MarcoGrazi/PR-02-NightCrawler-2017/Photoes/electronicsbox.jpg

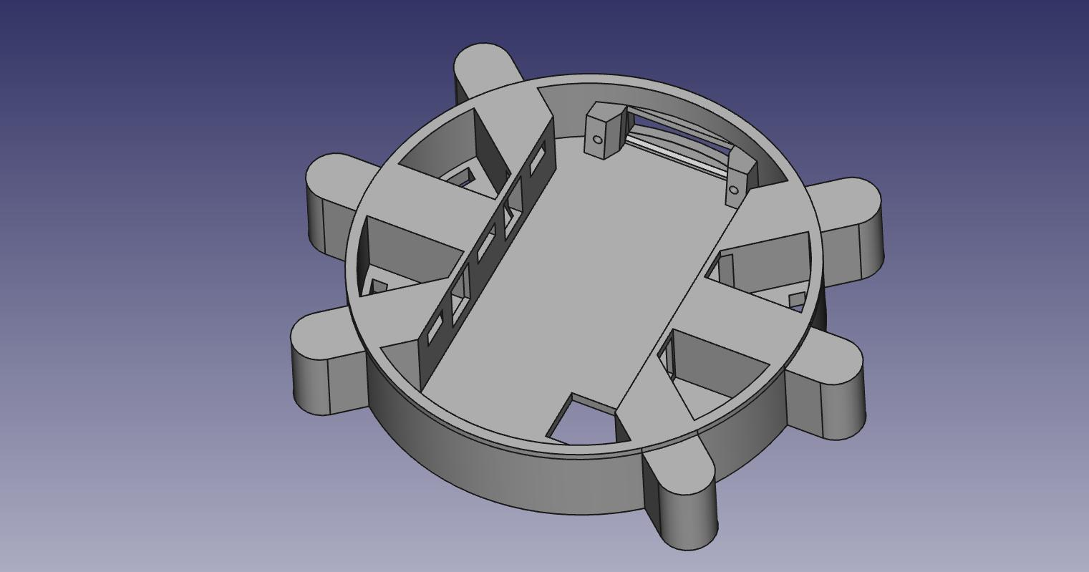
Photoes/electronicsbox.jpg
