MarcoGrazi/PR-02-NightCrawler-2017/Photoes/IMG_6573.jpg

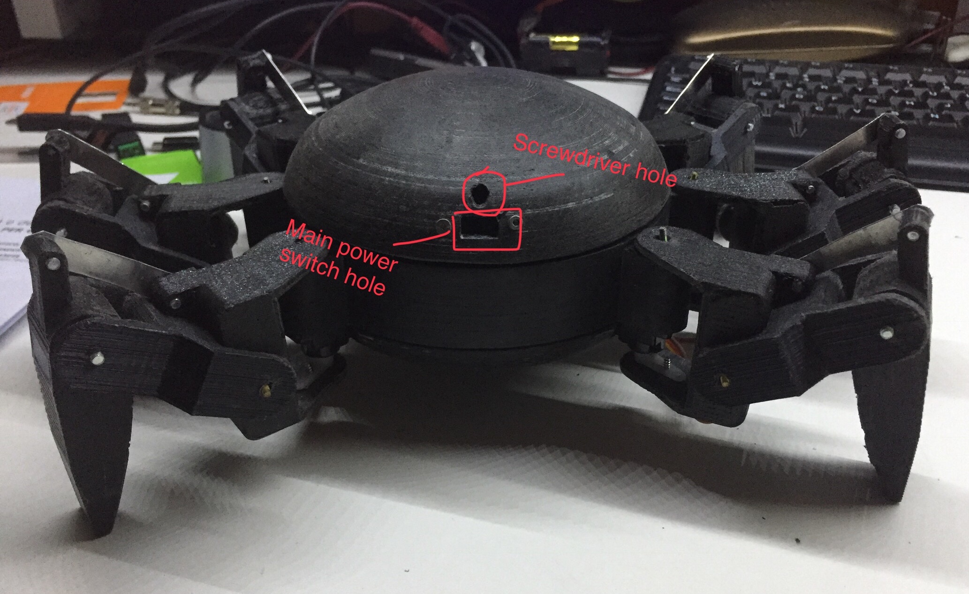
Photoes/IMG_6573.jpg
