MarcoGrazi/PR-02-NightCrawler-2017/Photoes/batterybox.png

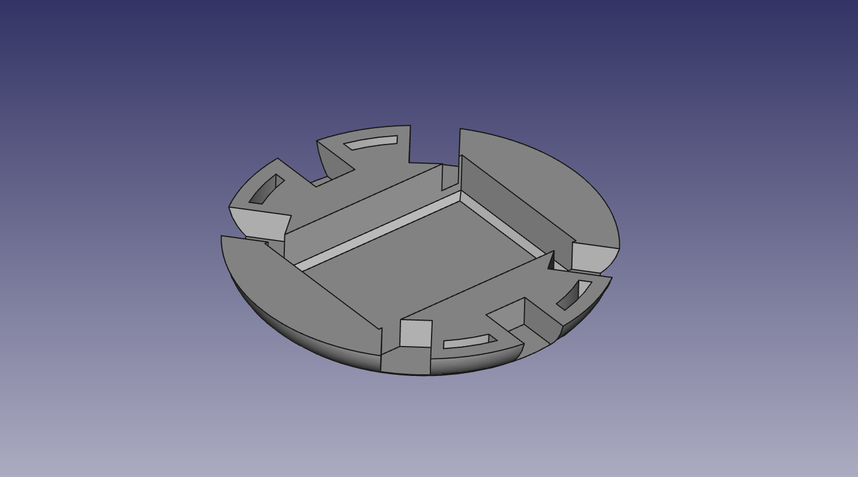
Photoes/batterybox.png
