MarcoGrazi/PR-02-NightCrawler-2017/Photoes/femurs.jpg

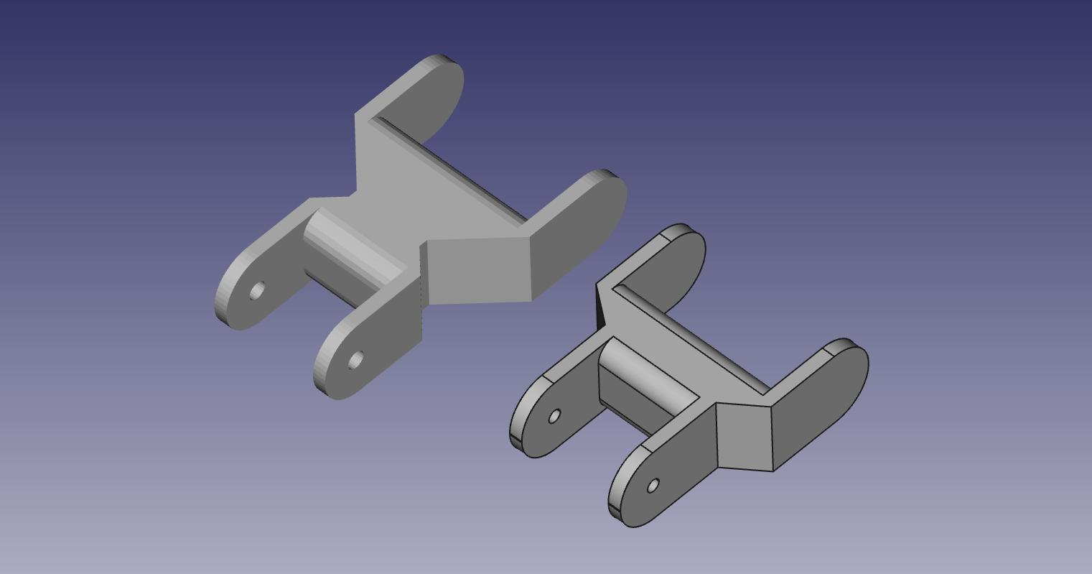
Photoes/femurs.jpg
