MarcoGrazi/PR-02-NightCrawler-2017/Photoes/head exterior.jpg

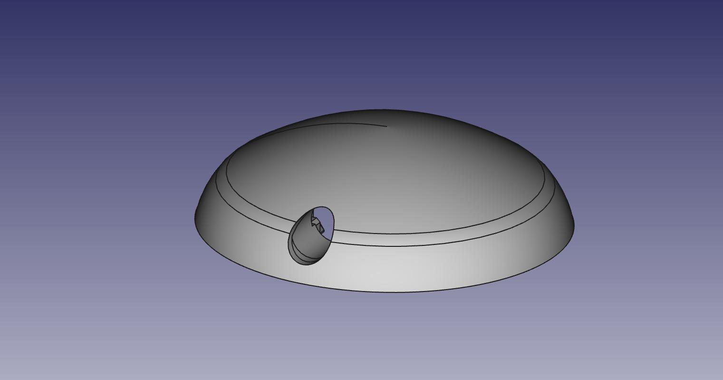
Photoes/head exterior.jpg
