MarcoGrazi/PR-02-NightCrawler-2017/Photoes/head interior.jpg

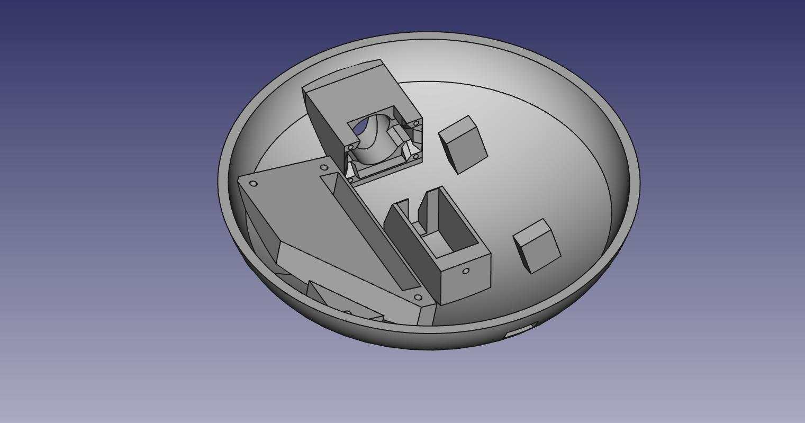
Photoes/head interior.jpg
