MarcoGrazi/PR-02-NightCrawler-2017/Photoes/IMG_6570.JPG

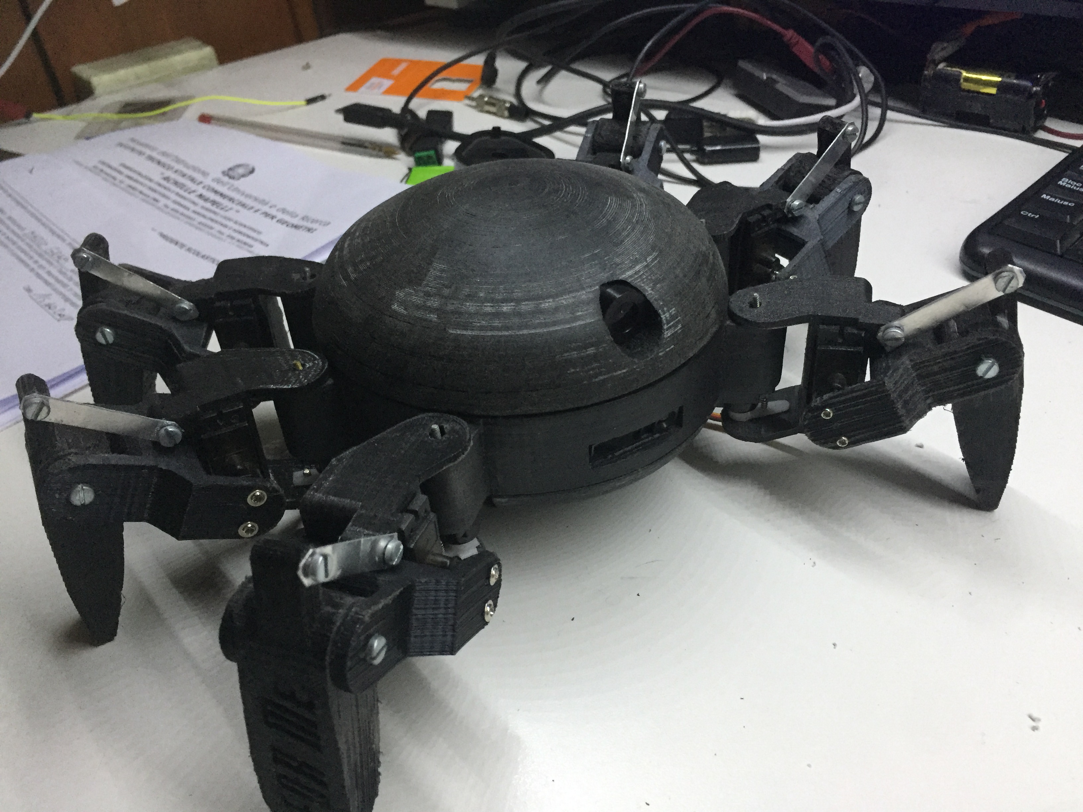
Photoes/IMG_6570.JPG
