MarcoGrazi/PR-02-NightCrawler-2017/Photoes/IMG_6571.JPG

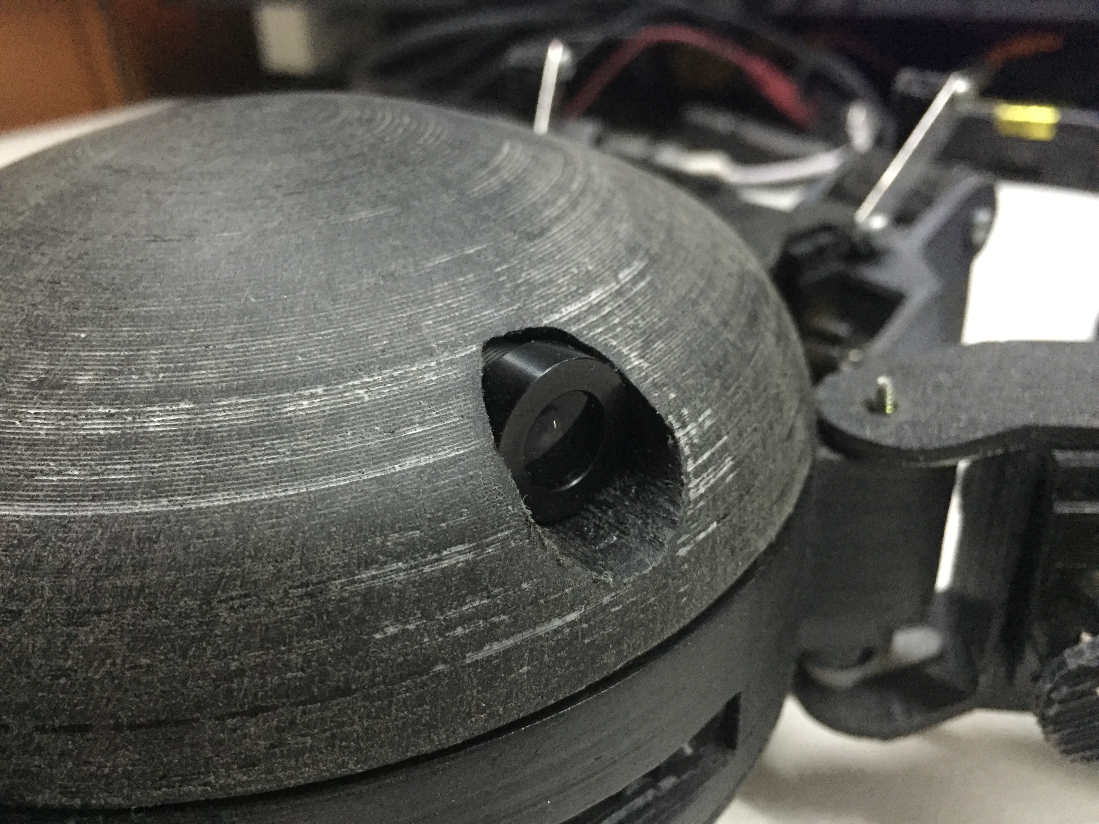
Photoes/IMG_6571.JPG
