MarcoGrazi/PR-02-NightCrawler-2017/Photoes/IMG_6574.JPG

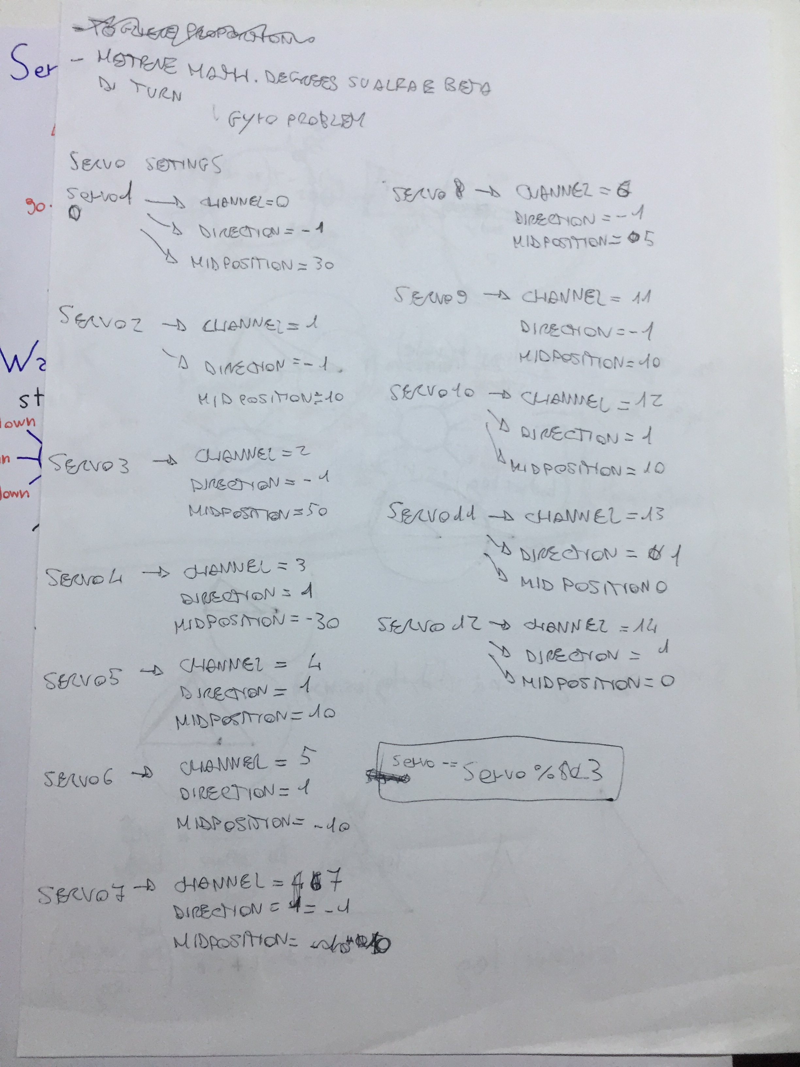
Photoes/IMG_6574.JPG
