MarcoGrazi/PR-02-NightCrawler-2017/Software/adc-05.png

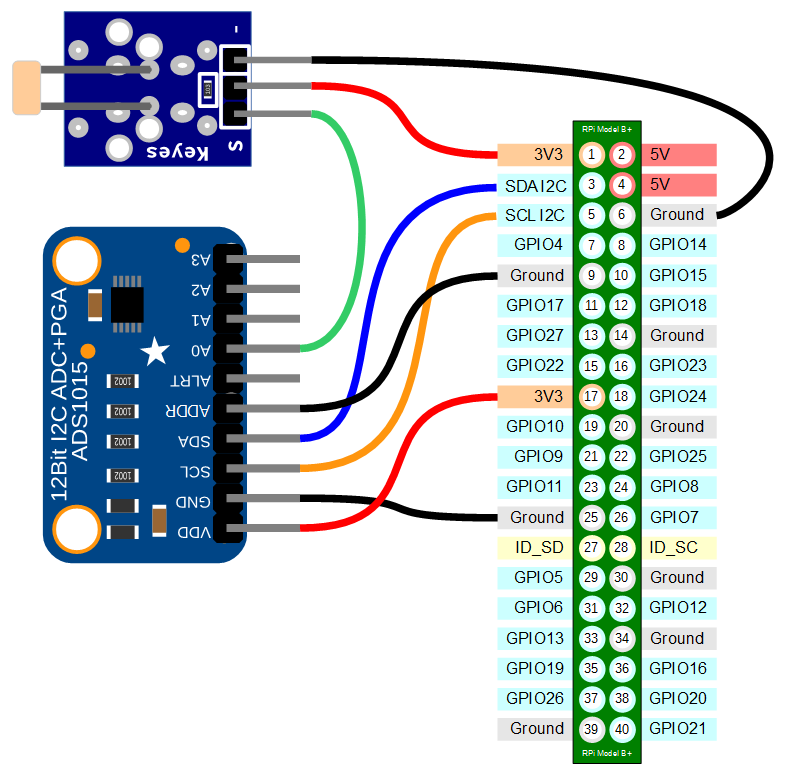
Software/adc-05.png
