MarcoGrazi/PR-02-NightCrawler-2017/CAD/main body/assembled/assembled.FCStd

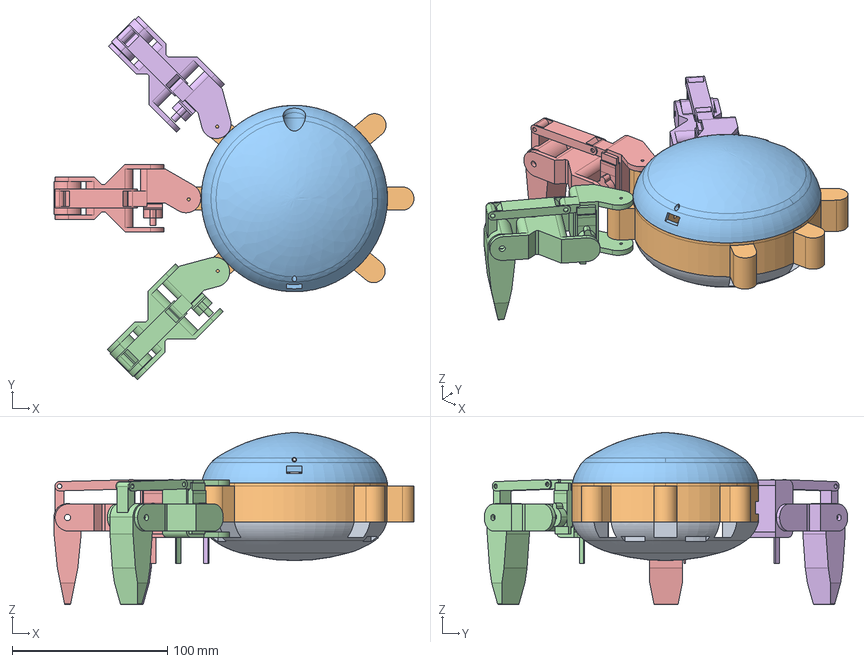
[picture p16: CAD file, 2020-03-03]
CAD/main body/assembled/assembled.FCStd
231.8 x 234.0 x 110.8 mm
