MarcoGrazi/PR-02-NightCrawler-2017/CAD/main body/assembled.FCStd

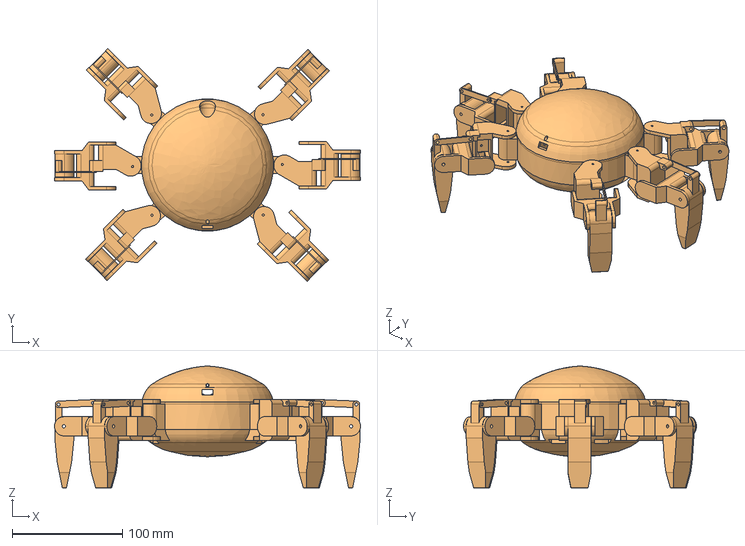
[picture p17: CAD file, 2020-03-03]
CAD/main body/assembled.FCStd
278.0 x 211.5 x 110.8 mm
