MarcoGrazi/PR-02-NightCrawler-2017/CAD/leg/femore/anca/anca.FCStd

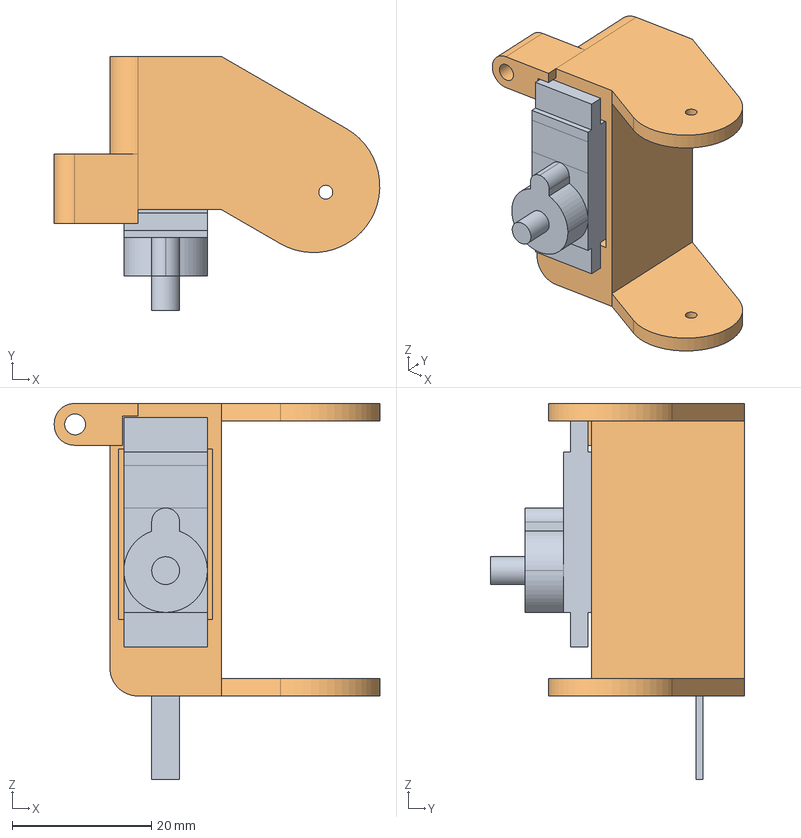
[picture p18: CAD file, 2020-03-03]
CAD/leg/femore/anca/anca.FCStd
46.8 x 36.5 x 54.0 mm
