MarcoGrazi/PR-02-NightCrawler-2017/CAD/leg/leg.FCStd

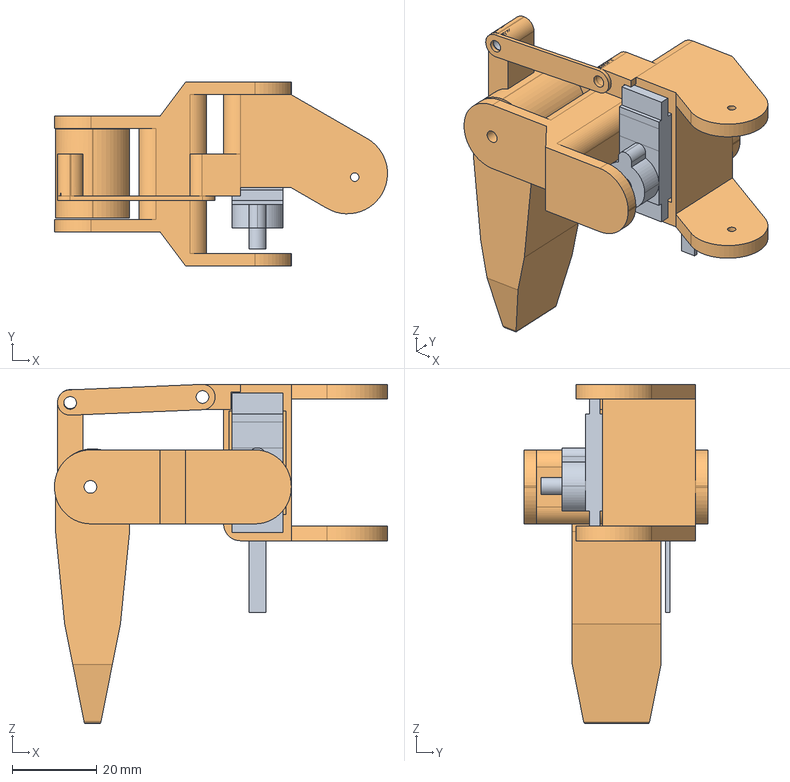
[picture p20: CAD file, 2020-03-03]
CAD/leg/leg.FCStd
78.8 x 43.5 x 80.2 mm
