MarcoGrazi/PR-02-NightCrawler-2017/CAD/leg/tendine/tendine.FCStd

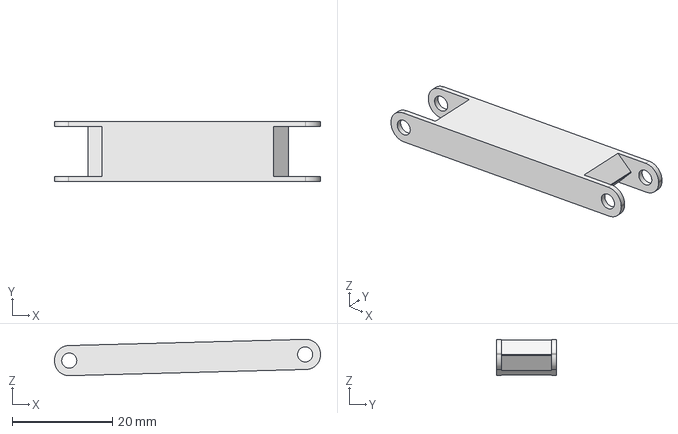
[picture p21: CAD file, 2020-03-03]
CAD/leg/tendine/tendine.FCStd
53.0 x 12.0 x 7.23 mm
