MarcoGrazi/PR-02-NightCrawler-2017/CAD/leg/tibia/For Me.stl

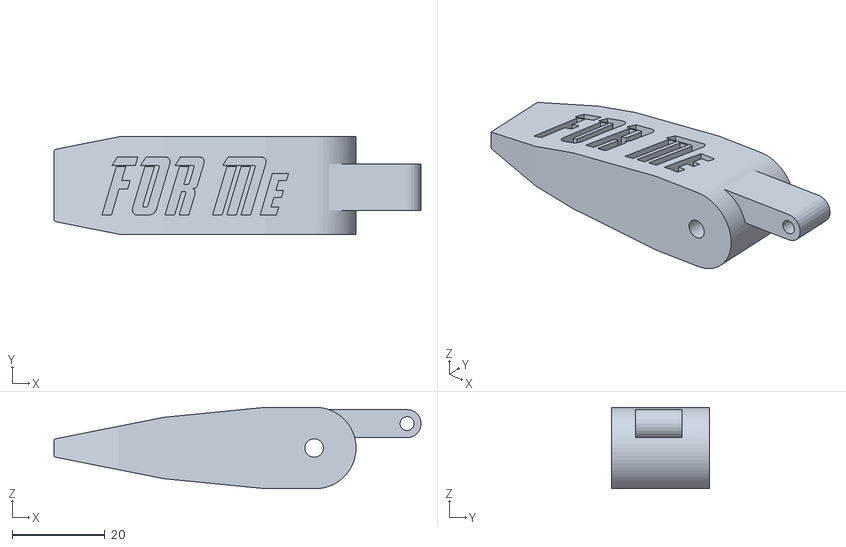
[picture p22: CAD file, 2020-03-03]
CAD/leg/tibia/For Me.stl
79.0 x 21.0 x 17.5
