MarcoGrazi/PR-02-NightCrawler-2017/CAD/main body/battery container/battery container.FCStd

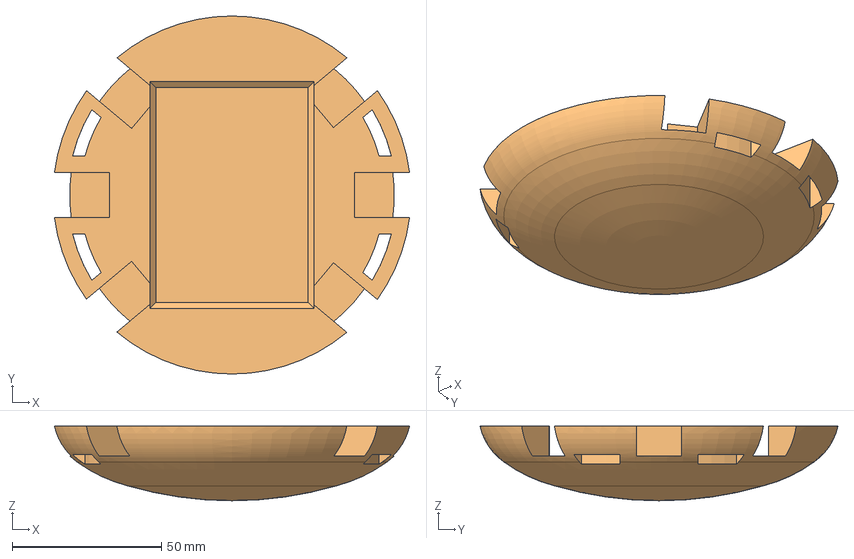
[picture p23: CAD file, 2020-03-03]
CAD/main body/battery container/battery container.FCStd
119.1 x 120.0 x 25.0 mm
