MarcoGrazi/PR-02-NightCrawler-2017/CAD/main body/battery.FCStd

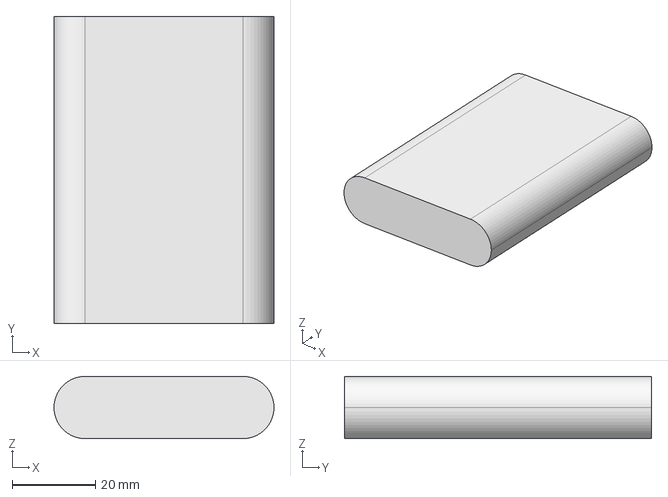
[picture p24: CAD file, 2020-03-03]
CAD/main body/battery.FCStd
53.0 x 74.0 x 15.0 mm
