MarcoGrazi/PR-02-NightCrawler-2017/CAD/main body/electronics box/electronics box.FCStd

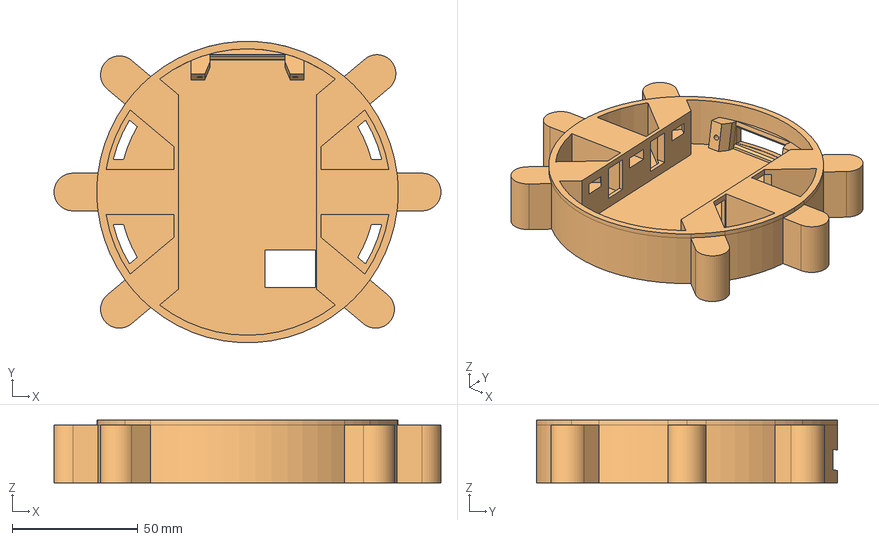
[picture p25: CAD file, 2020-03-03]
CAD/main body/electronics box/electronics box.FCStd
154.1 x 119.8 x 25.0 mm
