MarcoGrazi/PR-02-NightCrawler-2017/CAD/main body/testa/testa.stl

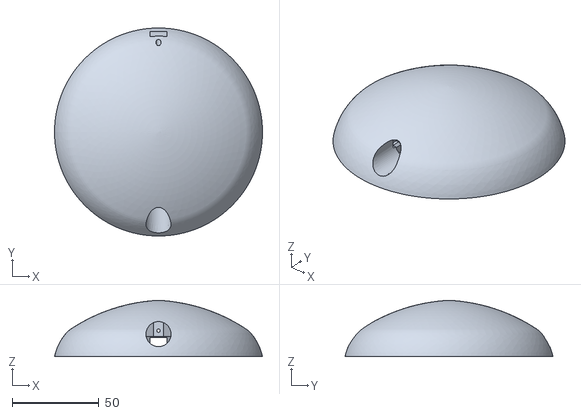
[picture p26: CAD file, 2020-03-03]
CAD/main body/testa/testa.stl
120.0 x 120.0 x 32.5
