MarcoGrazi/PR-02-NightCrawler-2017/CAD/leg/femore/femore.FCStd

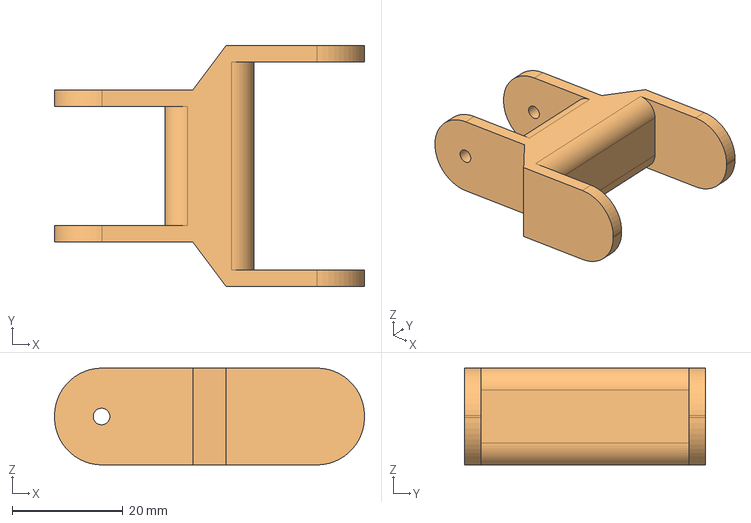
[picture p27: CAD file, 2020-03-03]
CAD/leg/femore/femore.FCStd
56.0 x 43.5 x 17.5 mm
