MarcoGrazi/PR-02-NightCrawler-2017/CAD/leg/tibia/tibia.FCStd

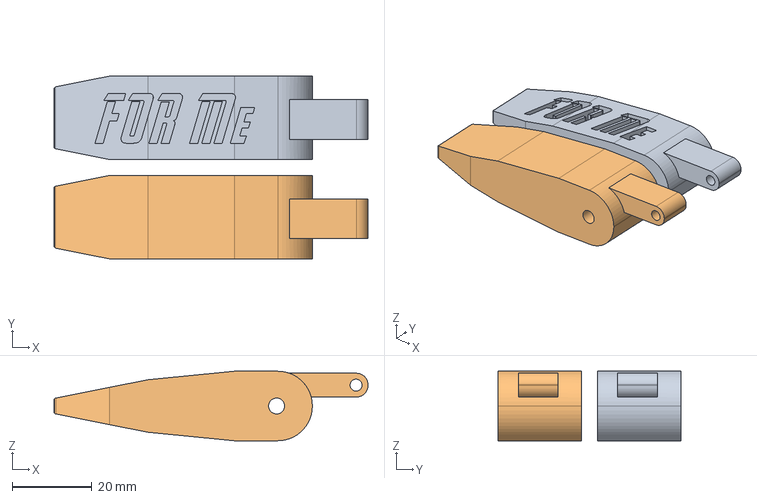
[picture p28: CAD file, 2020-03-03]
CAD/leg/tibia/tibia.FCStd
79.0 x 46.0 x 17.5 mm
