MarcoGrazi/PR-02-NightCrawler-2017/CAD/main body/assembled/nightcrawler.stl

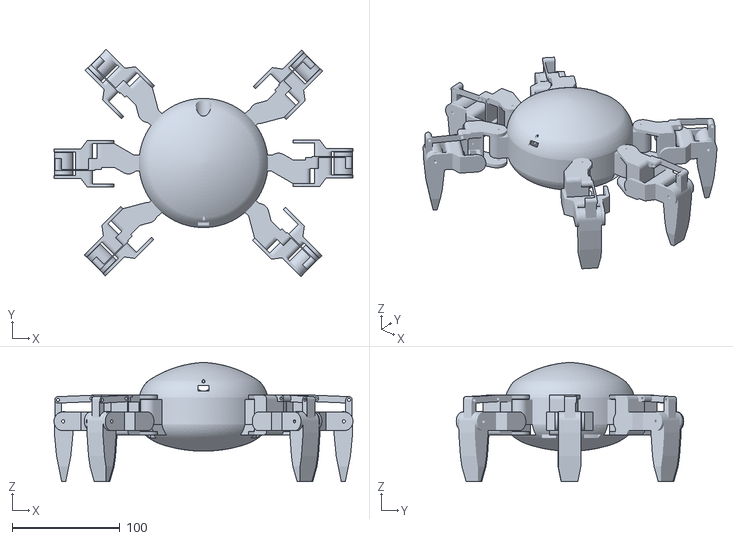
[picture p29: CAD file, 2020-03-03]
CAD/main body/assembled/nightcrawler.stl
278.0 x 211.5 x 110.8
