MarcoGrazi/PR-02-NightCrawler-2017/(list of files, cad)

Other CAD files:
CAD/leg/femore/anca/anca.stl
CAD/leg/femore/femore.stl
CAD/leg/tendine/tendine.stl
CAD/leg/tibia/tibia.stl
CAD/main body/battery container/battery container.stl
CAD/main body/electronics box/electronics box.stl
